hhtronik/qok-i-learn-soldering-smd-boost/README.md

HHTronik Q.O.K. / I learn soldering SMD Boost edition
=====================================================

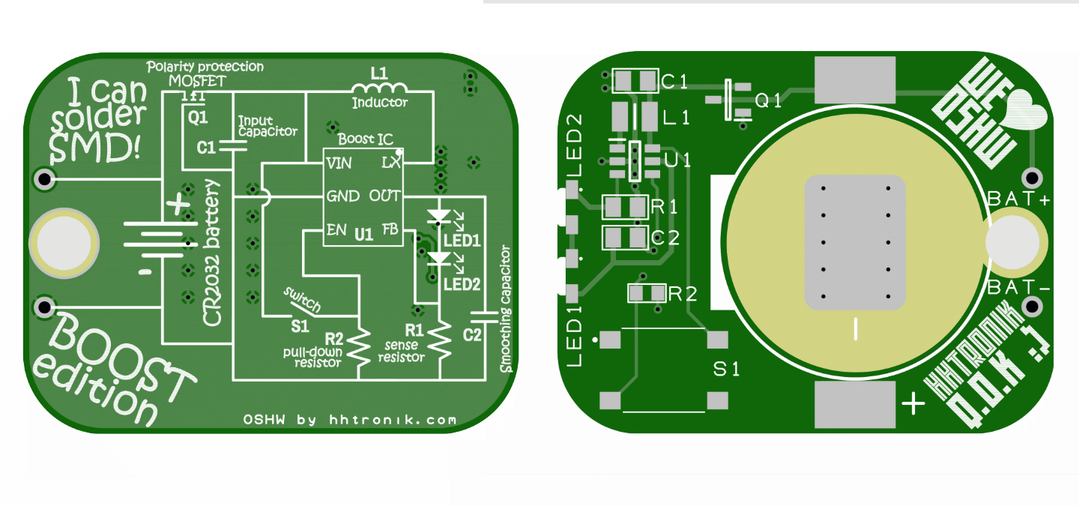
[picture p1: assets/pcb-rendering.png]
HHTronik Q.O.K. / I learn soldering SMD boost edition Q.O.K PCB rendering


Want to learn soldering SMT components and four components is not a challenge for you? 
Then this is for you! **I learn soldering SMD Boost edition** is our *level-up* kit from 
the super simple [I learn soldering SMD Q.O.K.](https://github.com/hhtronik/qok-i-learn-soldering-smd). 
Slightly smaller parts, a lot more circuit to dig through and your opportunity to build one of 
the most common switch mode power supply circuits!

On this board you have two white LEDs wired up in series, which means that you'd need at about
6V accross them to light them up, yet your power source is a mere 3V (when full) coin cell. 

How this work you ask? Read below!

>
> Note, while this is not challenging or difficult by any absolute measure, soldering small parts
> like those on this circuit can be tedious when you do this first. 
>
> Have a little patience, a steady hand and LOTs of flux ;)
>

What equipement do I need?
--------------------------

- A soldering iron, preferably one with a relatively fine tip
- Some solder, again, thinner one (< 1mm) will make your life easier
- Fine tip tweezers
- Patience

As always, work safety is important, so don't burn yourself and don't inhale the fumes released while soldering. Working in a well ventilated area is good. We'd definitely recommend adding some ventilation (for example a fan of some sort blowing the fumes away from you or a proper soldering fume extractor if you plan on doing this over and over again :)

Optionally you may have these things around:

- some flux (**you should have some**)
- rubbing alcool or isopropanol
- some lint-free cloth / paper towel
- a multimeter (ideally with a diode test mode)
- a magnifying glass

Assembly mini guide
-------------------

>
> we're expecting you did already solder at least some SMD passives previously. 
> If you didn't you should really go watch all of the videos below and maybe
> give one of our simpler SMD kits a try first.
>
> If you feel you need a refresh on soldering SMD parts, have a look at the 
> I learn soldering SMD instructions
>

1. solder Q1
2. solder C1
3. solder R1
4. solder C2
5. solder R2
6. measure you didn't short the positive rail (behing D1) to ground (center pad of the battery holder footprint)
7. solder L1
8. solder U1 (**watch out for pin 1 marks on package and PCB to line up** as in the picture below) (tip: add solder to on pad and tack the IC in place, then solder the remaining pins ;)
9. check for solder bridges on U1, check polarity again!
10. solder both LEDs (carefully! These are pretty heat sensitive!)
11. check the polarity by using the diode test mode. 
11. solder the switch
12. solder the battery holder
12. carefully inspect and measure everything again
13. insert a CR2025 or CR2032 cell (positive terminal toucing the metal bracket of the holder)
14. cross fingers and press the button!

Did it light up? :)

Troubleshooting
----------------

Here are some things you want to check:

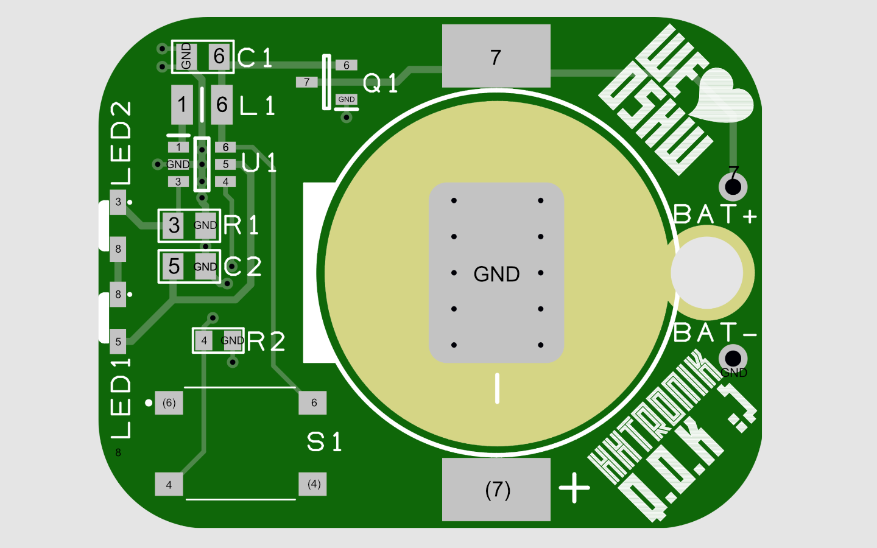
[picture p2: assets/troubleshooting.png]


| Pads / Test points | Multimeter mode | Expected result | Repairing it |
| --- | --- | --- | --- |
| `6` to `GND` | `resistance` | >500 KOhm | check for solder bridges around U1 and C1 |
| `1` to `GND` | `resistance` | >500 KOhm | check for solder bridges around U1 and C1 |
| `3` to `GND` | `resistance` | ~100Ohm | check R1 |
| `5` to `8` | `diode test` | With the positive terminal on `5` and COM/Negative on `8` LED1 should light up. | Fix polarity of LED1 |
| `8` to `3` | `diode test` | With the positive terminal on `8` and COM/Negative on `3` LED2 should light up. | Fix polarity of LED2 |
| `4` to `GND` | `resistance` | 400KOhm < x < 1MOhm | check the solder joints on U1, R2, S1 and the orientation of S1
| `4` to `6` | `continuity` | Open circuit when S1 **is not pressed** | check the orientation of S1
| `4` to `6` | `continuity` | Continuity when S1 **is pressed** | check the orientation of S1
| `4` to `6` | `continuity` | Continuity when S1 **is pressed** | check the orientation of S1

Orientation of components:

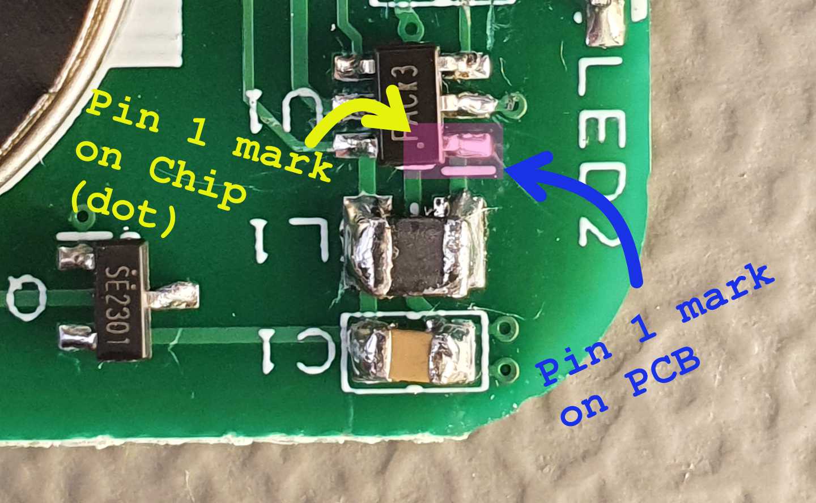
[picture p3: assets/closeup-details-ic-pins.jpg]


- U1 has a PIN1 mark on its case (small dot) which should align with the `pad 1` as in the image above
- LED1 has a green cathode mark on its side which should line up with `pad 8` (dot mark on silkscreen)
- LED2 has a green cathode mark on its side which should line up with `pad 3` (dot mark on silkscreen)

Polarity of SMT parts
---------------------

About a third of the components on this PCB are polarized, meaning that their orientation matters
for them to function properly. Different components have very different markings on their
case to show their orientation.

As these markings are often engraved into the case using a laser, they can be difficult to
read thus our recommendation you get some magnifying glass.

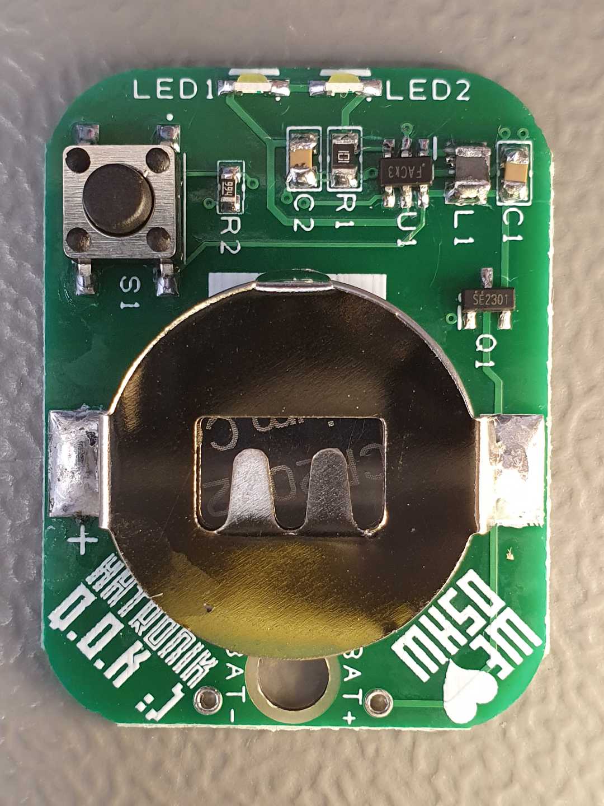
[picture p4: assets/finished-pcb.jpg]


The LEDs have a cathode band / mark on their back side which must align with the dot mark on the PCB:

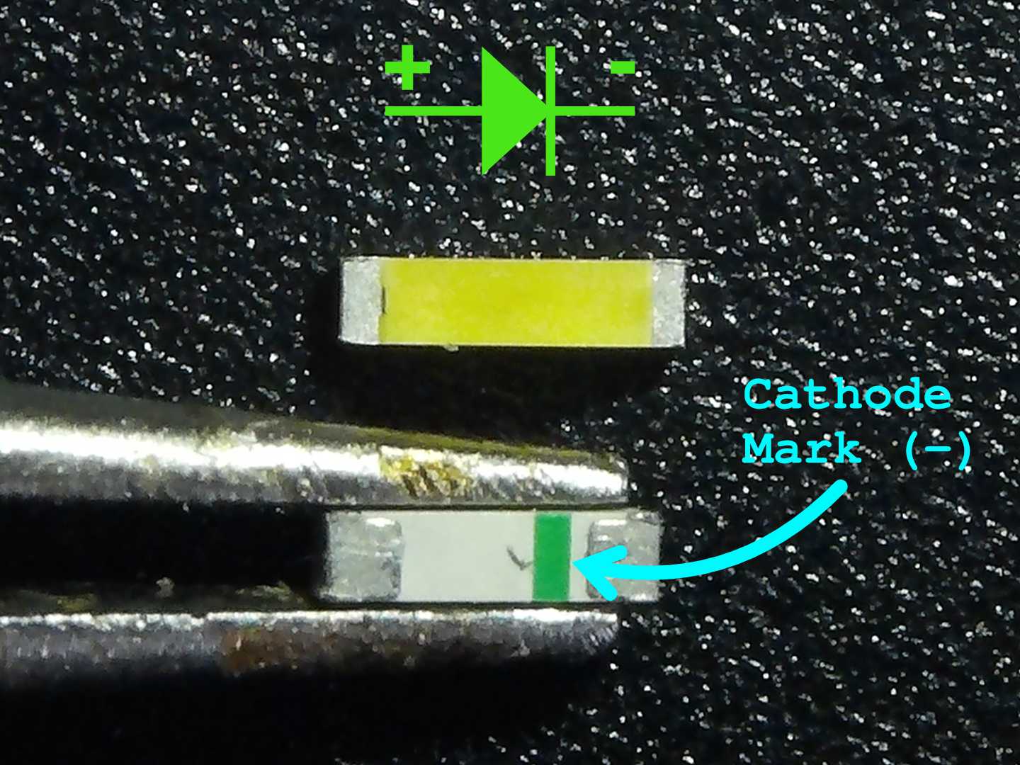
[picture p5: assets/side-view-led-pinout.jpg]


Components
----------

| Ref. | Part | Notes / Alternative parts  |
| ---- | --- | --- |
| Q1 | `On Semiconductors FDN306P` | Low RDS-On P-Channel MOSFET SOT23-3
| L1 | `Bourns CVH252009-4R7M` | `Murata 1239AS-H-4R7M` / 4.7uH 1008 multilayer inductor
| U1 | `Chipown AP2000ATCER` | Current mode step up converter SOT23-6
| C1 | `Samsung CL21B104KBCNNNC` | 100nF 0805 X7R 50V MLC capacitor
| C2 | `Samsung CL21B104KBCNNNC` | 100nF 0805 X7R 50V MLC capacitor
| R1 | `Panasonic ERJ-6ENF100RV` | 100 Ohm 0805 1% resistor
| R2 | `Panasonic ERJ-3GEYJ105V` | 1 MOhm 0603 5% resistor
| LED1 | `Inolux IN-S126ASUW` | Side view white LED If = 20mA 
| LED2 | `Inolux IN-S126ASUW` | Side view white LED If = 20mA
| S1 | `C&K PTS645SL50SMTR92` | Many surface mount tactile switches with a 6x6mm outline
| BAT1 | `Keystone Electronics 3034` | `Linx Technologies BAT-HLD-001` or `MPD BK-912-TR` or `Q&J WJ-CR2032-1-W`

I don't know anything about electronics, what can I learn?
----------------------------------------------------------

Besides soldering technique we'd say:

- what a boost/step-up converter is and how it works
- reverse polarity protection with a P-Channel MOSFET
- why some of the components were chosen

Watch others do
---------------

Some SMT soldering tutorials worth watching if you've never done this before

[LeoMakes / How to solder surface mount parts (it's easy!) ~ 19min](https://www.youtube.com/watch?v=f9fbqks3BS8)

[Collin's Lab / Surface Mount Soldering ~ 8min](https://www.youtube.com/watch?v=QzoPxvIM2qE)

[Tomislav Darlic / Soldering 1206 resistor ~ 2min](https://www.youtube.com/watch?v=_DsCdOaRUPM)

LICENCE
-------

This project is licenced under CERN Open Hardware Licence Version 2 - Strongly Reciprocal see LICENCE file for the full text.
