hhtronik/qok-i-learn-soldering-smd-boost/schematic.pdf

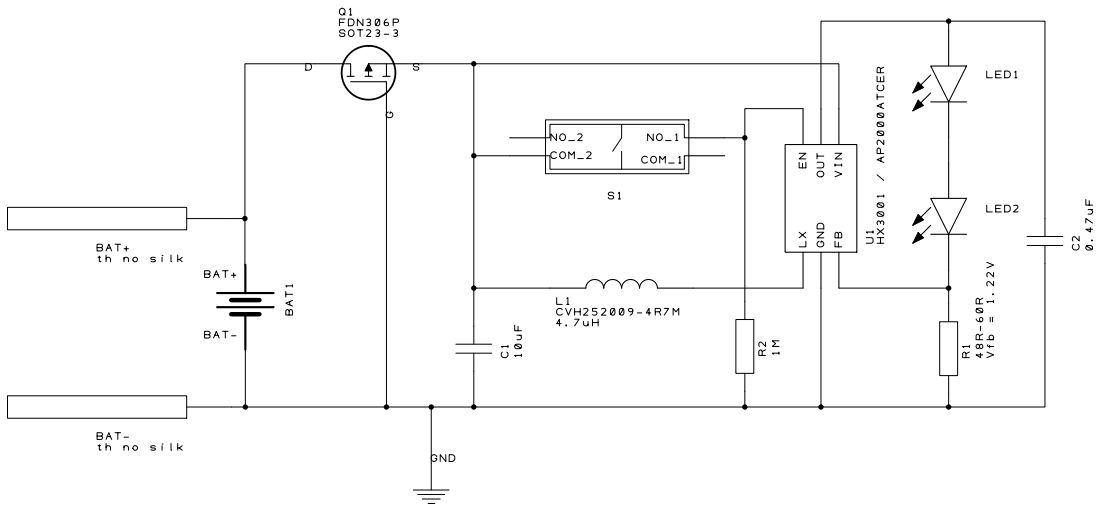
[picture p6: page 1]
