hhtronik/qok-i-learn-soldering-smd-boost/(list of files, drawings)

Other design files:
designspark/hhtqok-ils-smd-boost-edition.pcb
