hhtronik/qok-i-learn-soldering-smd-boost/(commit log)

2020-04-01 Fixed the part name and nominal value of the used inductor
    [hhtqok-ils-smd-boost-edition.pcb, hhtqok-ils-smd-boost-edition.sch]
2020-04-06 Swapped diode based reverse polarity protection agains P-MOS based one to avoid diode drop
    [hhtqok-ils-smd-boost-edition.pcb, hhtqok-ils-smd-boost-edition.sch]
2020-06-19 Updated pcb renderings and fixed parts table values
